Ajay1997/ARM-Assembly/README.md

# ARM-Assembly
ECE 362 Final Project. Motion controlled ARM using STM32F0Discovery, BWT61 Bluetooth MPU6050 and HC05
