Ajay1997/ARM-Assembly/Src/main.c

/**
  ******************************************************************************
  * @file           : main.c
  * @brief          : Main program body
  ******************************************************************************
  ** This notice applies to any and all portions of this file
  * that are not between comment pairs USER CODE BEGIN and
  * USER CODE END. Other portions of this file, whether 
  * inserted by the user or by software development tools
  * are owned by their respective copyright owners.
  *
  * COPYRIGHT(c) 2018 STMicroelectronics
  *
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
  ******************************************************************************
  */
/* Includes ------------------------------------------------------------------*/
#include "main.h"
#include "stm32f0xx_hal.h"
#include "tim.h"
#include "usart.h"
#include "gpio.h"

/* USER CODE BEGIN Includes */
#include "dic.h"
#include <stdbool.h>
#include <string.h>
#include <stdlib.h>
#define LCD_DELAY 1

/* USER CODE END Includes */


/* USER CODE BEGIN PV */
struct gpioPin data595 = {'B', 11};
struct gpioPin clock595 = {'B', 10};
struct gpioPin latch595 = {'B', 2};
struct gpioPin lcdRegSel = {'B', 1};
struct gpioPin lcdEn = {'C', 5};
struct gpioPin lcdRw = {'B', 0};


uint8_t mpuData[66] = {0};
int flag1 = 0;
int flag2 = 0;
int flag3 = 0;
int valy = 1500;
int valL, valR, valC;
int clawState = -1;
volatile float Ax, Ay, Az;
volatile float accZ, laccZ;
volatile float lAz = 0;
volatile int tempFlag = 0;
int maxValL, minValL;
int maxValR, minValR;
int maxValC, minValC;
int maxValB, minValB;
int perR, perL, perB, perC;
int msCount = 0;
/* USER CODE END PV */

void SystemClock_Config(void);

/* USER CODE BEGIN PFP */
void HAL_UART_RxCpltCallback(UART_HandleTypeDef* huart);



void lcdFreshString(char* val, uint8_t line);
void lcdWriteChar(uint8_t val);
void lcdClear();
void lcdSetup();
void lcdCommand(uint8_t comm);
void shiftIn(struct gpioPin data, struct gpioPin clock, struct gpioPin latch, uint8_t val);
void pinWrite(struct gpioPin target, bool val);
void lcdFullDisplay(char* val1, char* val2);
void showMotorStatus();

/* USER CODE END PFP */

/**
  * @brief  The application entry point.
  *
  * @retval None
  */
int main(void)
{
  /* USER CODE BEGIN 1 */
    minValC = 900;
    maxValC = 1300;
    minValB = 600;
    maxValB = 2300;
    minValL = 1320;
    maxValL = 1380;
    minValR = 1000;
    maxValR = 2300;

  /* USER CODE END 1 */

  /* MCU Configuration----------------------------------------------------------*/

  /* Reset of all peripherals, Initializes the Flash interface and the Systick. */
  HAL_Init();

  /* Configure the system clock */
  SystemClock_Config();

  /* Initialize all configured peripherals */
  MX_GPIO_Init();
  MX_USART1_UART_Init();
  MX_TIM2_Init();
  MX_TIM1_Init();
  lcdSetup();
  lcdFullDisplay("ARM ASSEMBLY", "L: XX% R: XX% B: XX%");
  /* USER CODE BEGIN 2 */
  HAL_TIM_Base_Start_IT(&htim1);
  HAL_TIM_PWM_Start(&htim2, TIM_CHANNEL_1);
  HAL_TIM_PWM_Start(&htim2, TIM_CHANNEL_2);
  HAL_TIM_PWM_Start(&htim2, TIM_CHANNEL_3);
  HAL_TIM_PWM_Start(&htim2, TIM_CHANNEL_4);
  __HAL_TIM_SET_COMPARE(&htim2, TIM_CHANNEL_1, 1500); //Bottom motor (controls arm L/R rotate) (600-2400)
  __HAL_TIM_SET_COMPARE(&htim2, TIM_CHANNEL_2, 1000); //right motor (controls reach?) (1000-2000)
  __HAL_TIM_SET_COMPARE(&htim2, TIM_CHANNEL_3, 1320); //left motor (controls reach?) (1000-2000) //1300 central
  __HAL_TIM_SET_COMPARE(&htim2, TIM_CHANNEL_4, 1300); //claw motor (900 is closed, 1300 is open)
  valL = 1320;
  valR = 1300;
  valC = 1300;
  showMotorStatus();
  //full extension (left: 1400, right: 2300)
  //middle max height (left: 1300, right: 1000)

  /* USER CODE END 2 */

  /* Infinite loop */
  /* USER CODE BEGIN WHILE */
  while (1)
  {
      HAL_UART_Receive_IT(&huart1, mpuData, 66);



  /* USER CODE END WHILE */

  /* USER CODE BEGIN 3 */

  }
  /* USER CODE END 3 */

}

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
/* USER CODE BEGIN 4 */
void showMotorStatus()
{
    char line1[16];
    char line2[16];
    perC = 100.0 * (valC - minValC) / (maxValC - minValC);
    perB = 100.0 * (valy - minValB) / (maxValB - minValB);
    perL = 100.0 * (valL - minValL) / (maxValL - minValL);
    perR = 100.0 * (valR - minValR) / (maxValR - minValR);
    sprintf(line1, "L %03d %% R %03d %%", perL, perR);
    sprintf(line2, "B %03d %% C %03d %%", perB, perC);
    lcdFullDisplay(line1, line2);
}

void myTIM1IRQ()
{
    if(Ax > 50 && Ax < 300){
           flag1 = -1;
           HAL_GPIO_WritePin(GPIOC, GPIO_PIN_8, GPIO_PIN_SET);
           HAL_GPIO_WritePin(GPIOC, GPIO_PIN_9, GPIO_PIN_RESET);
    }

       else if(Ax < -50 && Ax > -300){
           flag1 = 1;
       HAL_GPIO_WritePin(GPIOC, GPIO_PIN_8, GPIO_PIN_RESET);
       HAL_GPIO_WritePin(GPIOC, GPIO_PIN_9, GPIO_PIN_SET);}
       else{
           flag1 = 0;
       HAL_GPIO_WritePin(GPIOC, GPIO_PIN_8, GPIO_PIN_RESET);
       HAL_GPIO_WritePin(GPIOC, GPIO_PIN_9, GPIO_PIN_RESET);
    }
    if(Ay > 50 && Ay < 300)
    {
        flag2 = 1;
    }
    else if(Ay < -50 && Ay > -300)
    {
        flag2 = -1;
    }
    else
    {
        flag2 = 0;
    }

    // state machine CLAW
    if(tempFlag == 2)
    {
        if(valC == 1300)
            valC = 900;
        else if(valC == 900)
            valC = 1300;
        tempFlag = 0;
    }
    __HAL_TIM_SET_COMPARE(&htim2,TIM_CHANNEL_4, valC);

    if (flag1 == 1){
        valy+=50;
        if(valy>=2300){
            valy=2300;
        }
        __HAL_TIM_SET_COMPARE(&htim2,TIM_CHANNEL_1,valy);
    }
    else if (flag1 == -1){
         valy-=50;
         if(valy<=600){
             valy=600;
         }
         __HAL_TIM_SET_COMPARE(&htim2,TIM_CHANNEL_1,valy);
    }
    //full extension (left: 1400, right: 2300)
    //middle max height (left: 1300, right: 1000)
    if (flag2 == 1){
        valL -= 10;
        valR -= 130;
        if(valL <= 1320)
            valL = 1320;
        if(valR <= 1000)
            valR = 1000;

        __HAL_TIM_SET_COMPARE(&htim2,TIM_CHANNEL_2,valR);
        __HAL_TIM_SET_COMPARE(&htim2,TIM_CHANNEL_3,valL);
    }
    else if (flag2 == -1){
        valL += 10;
        valR += 130;
        if(valL >= 1380)
            valL = 1380;
        if(valR >= 2300)
            valR = 2300;
        __HAL_TIM_SET_COMPARE(&htim2,TIM_CHANNEL_2,valR);
        __HAL_TIM_SET_COMPARE(&htim2,TIM_CHANNEL_3,valL);
    }
    msCount += 50;
    if(msCount == 300)
    {
        showMotorStatus();
        msCount = 0;
    }

}
void HAL_UART_RxCpltCallback(UART_HandleTypeDef* huart)
{
    for(int i=0; i<65;i++){
        if(mpuData[i] == 0x55 && mpuData[i+1]==0x52 && (i+7 <=65)){
            Ax = ((short)(mpuData[i+3]<<8 | mpuData[i+2]))/32768.0*2000;
            Ay = ((short)(mpuData[i+5]<<8 | mpuData[i+4]))/32768.0*2000;
            Az = ((short)(mpuData[i+7]<<8 | mpuData[i+6]))/32768.0*2000;
        }
        if(mpuData[i] == 0x55 && mpuData[i+1] == 0x51 && (i + 7) <= 65)
        {
            accZ = ((short)(mpuData[i+7] << 8 | mpuData[i+6]))/32768.0*16;
        }
        if(accZ > 0.5 && tempFlag == 0)
        {
            tempFlag = 1;
        }
        if(accZ < -0.5 && tempFlag == 1)
        {
            tempFlag = 2;
        }

    }

    return;
}

void lcdFullDisplay(char* val1, char* val2)
{
    char* lol = val1;
    lcdClear();
    while(*lol)
    {
        lcdWriteChar(*lol);
        lol++;
    }
    pinWrite(lcdRegSel, false);
    pinWrite(lcdRw, false);
    lcdCommand(0xC0);
    lol = val2;
    while(*lol)
    {
        lcdWriteChar(*lol);
        lol++;
    }
}

// Prints given string on particular line of the
// LCD display
void lcdFreshString(char* val, uint8_t line)
{
    char* lol = val;
    lcdClear();
    if(line == 1)
    {
        while(*lol != 0)// && *lol != '\n' && *lol != '\r')
        {
            lcdWriteChar(*lol);
            lol++;
        }
    }
    else
    {
        pinWrite(lcdRegSel, false);
        pinWrite(lcdRw, false);
        lcdCommand(0xC0);
        while(*lol)
        {
            lcdWriteChar(*lol);
            lol++;
        }
    }
}

// Writes a particular character to the LCD and advances the cursor
void lcdWriteChar(uint8_t val)
{
    pinWrite(lcdRw, false);
    pinWrite(lcdRegSel, true);
    lcdCommand(val);
}

// Clears the LCD and moves cursor to the beginning
void lcdClear()
{
    pinWrite(lcdRw, false);
    pinWrite(lcdRegSel, false);
    lcdCommand(0x01);
    pinWrite(lcdEn, true);
    pinWrite(lcdEn, false);
    //HAL_Delay(LCD_DELAY);
}

// Initialises the LCD in 8-bit mode
void lcdSetup()
{
    HAL_Delay(LCD_DELAY * 8);
    pinWrite(lcdRegSel, false); // command mode enabled
    pinWrite(lcdRw, false); //write mode
    lcdCommand(0x38); //send function set
    lcdCommand(0x0C); //cursor off, display on
    lcdCommand(0x01); //clear
    lcdCommand(0x06);
    HAL_Delay(LCD_DELAY);

}

// Give a command to the LCD to execute
void lcdCommand(uint8_t comm)
{
    pinWrite(lcdEn, false);
    shiftIn(data595, clock595, latch595, comm);
    pinWrite(lcdEn, true);
    HAL_Delay(LCD_DELAY);
    pinWrite(lcdEn, false);
   // HAL_Delay(LCD_DELAY);
}

// HC595 shift register instruction
void shiftIn(struct gpioPin data, struct gpioPin clock, struct gpioPin latch, uint8_t val)
{
    char x = 0;
    pinWrite(clock, false);
    pinWrite(latch, false);
    for(int i = 0; i < 8; ++i)
    {
        x = val & 0x80;
        if (x)
        {
            pinWrite(data, true);
        }
        else
        {
            pinWrite(data, false);
        }
        pinWrite(clock, true);
        pinWrite(clock, false);
        val = val << 1;
    }
    pinWrite(latch, true);
    pinWrite(latch, false);
}

// Write a value to the given pin
void pinWrite(struct gpioPin target, bool val)
{
    if(val == true)
    {
        HAL_GPIO_WritePin(gpioDecode(target.gpio), pinDecode(target.pin), GPIO_PIN_SET);
    }
    else
    {
        HAL_GPIO_WritePin(gpioDecode(target.gpio), pinDecode(target.pin), GPIO_PIN_RESET);
    }
}

/* USER CODE END 4 */
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
