Ajay1997/ARM-Assembly/ARM_ASSEMBLY.ioc

Mcu.UserName=STM32F051R8Tx
PA0.GPIO_Label=B1 [Blue PushButton]
PA0.Signal=GPXTI0
PA1.Signal=S_TIM2_CH2
PA10.Signal=USART1_RX
PA13.GPIO_Label=SWDIO
PA13.Signal=SYS_SWDIO
PA14.GPIO_Label=SWCLK
PA14.Signal=SYS_SWCLK
PA2.Signal=S_TIM2_CH3
PA3.Signal=S_TIM2_CH4
PA5.Signal=S_TIM2_CH1_ETR
PA9.Signal=USART1_TX
PC8.GPIO_Label=LD4 [Blue Led]
PC8.Signal=GPIO_Output
PC9.GPIO_Label=LD3 [Green Led]
PC9.Signal=GPIO_Output
